kylerbrown/headstage_nano/README.md

# HeadstageNano2

A small Intan RHD2000 amplifier PCB. Design is almost identical to one recievied from Hamish Mehaffey, with the addition of working impedance checks.
