kylerbrown/headstage_nano/headstageNano.brd

## EAGLE design headstageNano.brd (2015-10-08)

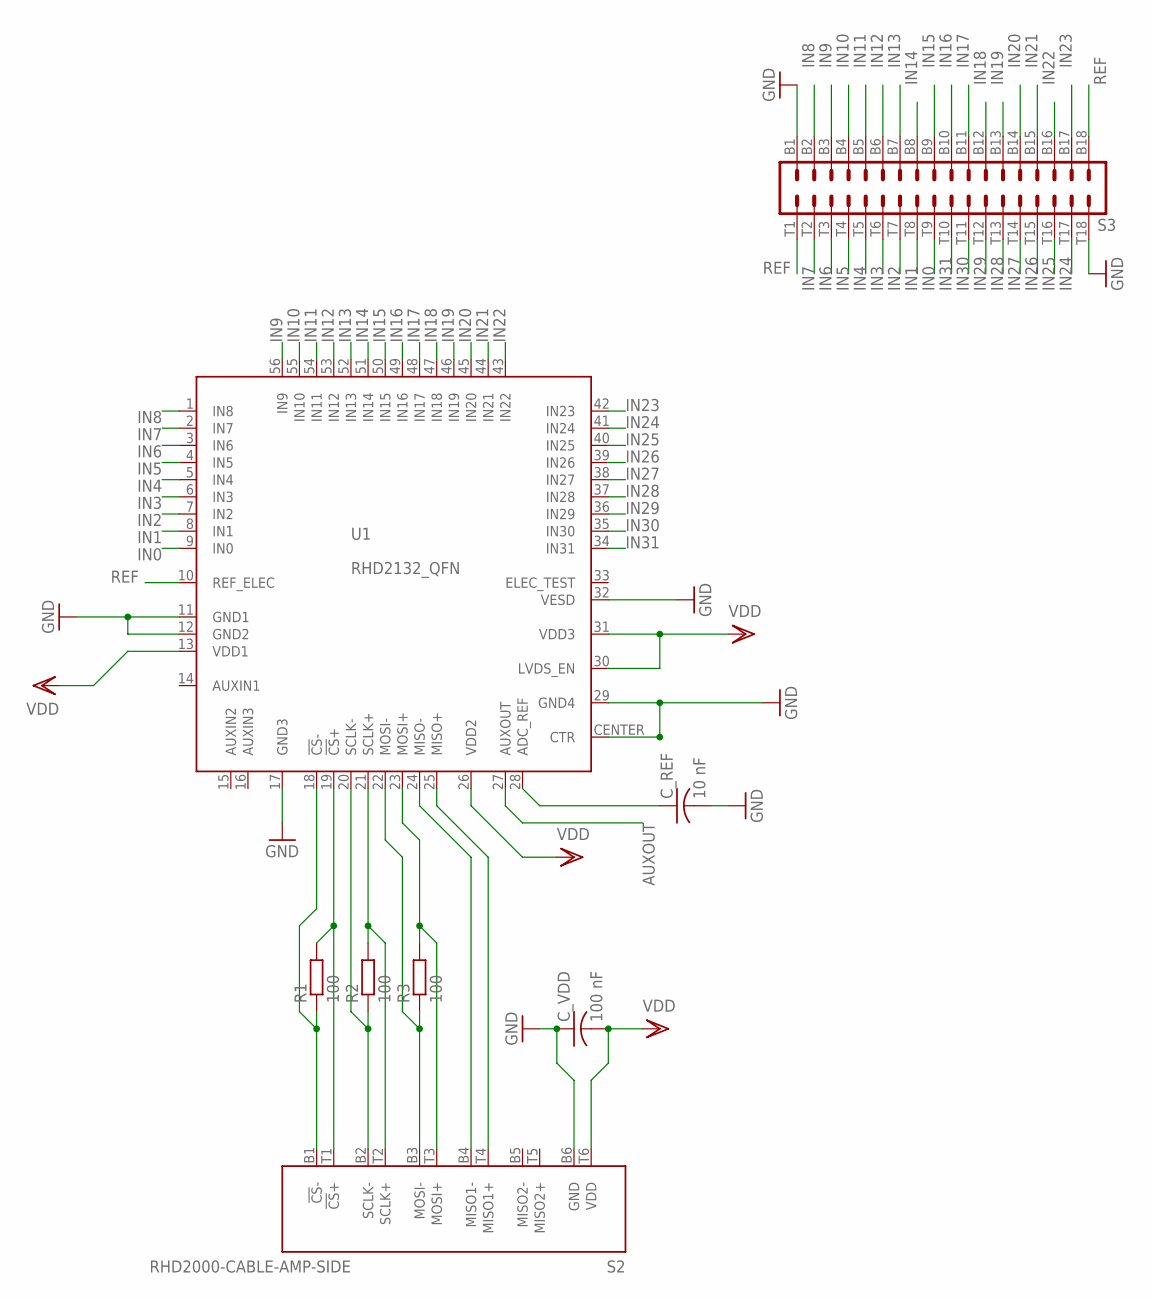
[picture p1: schematic headstageNano.sch]

Parts:
C_REF: 10 nF; C0402K
C_VDD: 100 nF; C0402K
R1, R2, R3: 100; R0402
S2: RHD2000-CABLE-AMP-SIDE; OMNETICS_PZN-12-AA
S3: OMNETICS_A79025
U1: RHD2132_QFN; QFN56_8_X_8_LARGE

Connections:
ADC_REF: C_REF.1, U1.28 (ADC_REF)
AUXOUT: U1.27 (AUXOUT)
CS+: R1.2, S2.T1 (!CS!+), U1.19 (!CS!+)
CS-: R1.1, S2.B1 (!CS!-), U1.18 (!CS!-)
GND: C_REF.2, C_VDD.1, S2.B6 (GND), S3.B1, S3.T18, U1.11 (GND1), U1.12 (GND2), U1.17 (GND3), U1.29 (GND4), U1.32 (VESD), U1.CENTER (CTR)
IN0: S3.T9, U1.9 (IN0)
IN1: S3.T8, U1.8 (IN1)
IN2: S3.T7, U1.7 (IN2)
IN3: S3.T6, U1.6 (IN3)
IN4: S3.T5, U1.5 (IN4)
IN5: S3.T4, U1.4 (IN5)
IN6: S3.T3, U1.3 (IN6)
IN7: S3.T2, U1.2 (IN7)
IN8: S3.B2, U1.1 (IN8)
IN9: S3.B3, U1.56 (IN9)
IN10: S3.B4, U1.55 (IN10)
IN11: S3.B5, U1.54 (IN11)
IN12: S3.B6, U1.53 (IN12)
IN13: S3.B7, U1.52 (IN13)
IN14: S3.B8, U1.51 (IN14)
IN15: S3.B9, U1.50 (IN15)
IN16: S3.B10, U1.49 (IN16)
IN17: S3.B11, U1.48 (IN17)
IN18: S3.B12, U1.47 (IN18)
IN19: S3.B13, U1.46 (IN19)
IN20: S3.B14, U1.45 (IN20)
IN21: S3.B15, U1.44 (IN21)
IN22: S3.B16, U1.43 (IN22)
IN23: S3.B17, U1.42 (IN23)
IN24: S3.T17, U1.41 (IN24)
IN25: S3.T16, U1.40 (IN25)
IN26: S3.T15, U1.39 (IN26)
IN27: S3.T14, U1.38 (IN27)
IN28: S3.T13, U1.37 (IN28)
IN29: S3.T12, U1.36 (IN29)
IN30: S3.T11, U1.35 (IN30)
IN31: S3.T10, U1.34 (IN31)
MISO1+: S2.T4 (MISO1+), U1.25 (MISO+)
MISO1-: S2.B4 (MISO1-), U1.24 (MISO-)
MOSI+: R3.2, S2.T3 (MOSI+), U1.23 (MOSI+)
MOSI-: R3.1, S2.B3 (MOSI-), U1.22 (MOSI-)
REF: S3.B18, S3.T1, U1.10 (REF_ELEC)
SCLK+: R2.2, S2.T2 (SCLK+), U1.21 (SCLK+)
SCLK-: R2.1, S2.B2 (SCLK-), U1.20 (SCLK-)
VDD: C_VDD.2, S2.T6 (VDD), U1.13 (VDD1), U1.26 (VDD2), U1.30 (LVDS_EN), U1.31 (VDD3)

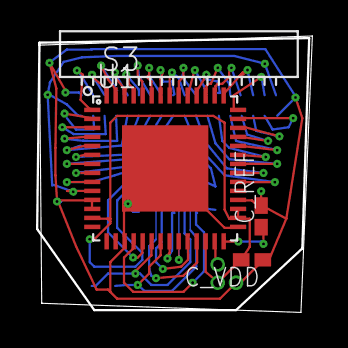
[picture p2: board headstageNano.brd from above]

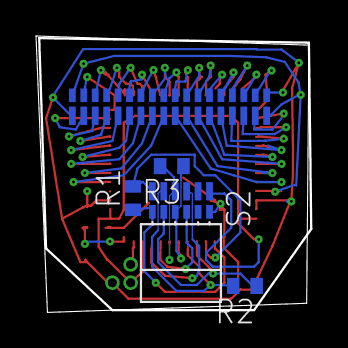
[picture p3: board headstageNano.brd from below]

Board: 2 copper layers, 15.3 x 15.4 mm, 8 parts (4 on the bottom side), 44 nets.
