kylerbrown/headstage_nano/(commit log)

2015-09-28 ungrounded pin 33 elec_test for impedance tests
    [headstageNano.brd, headstageNano.sch]
2015-09-29 adding a connection diagram pdf and a parts list
    [parts-list.csv]
2015-10-08 updating capacitor values
    [headstageNano.brd, headstageNano.sch]
